bobbyfordmusic-collab/visaverse-site/parts/1_BASE.3mf

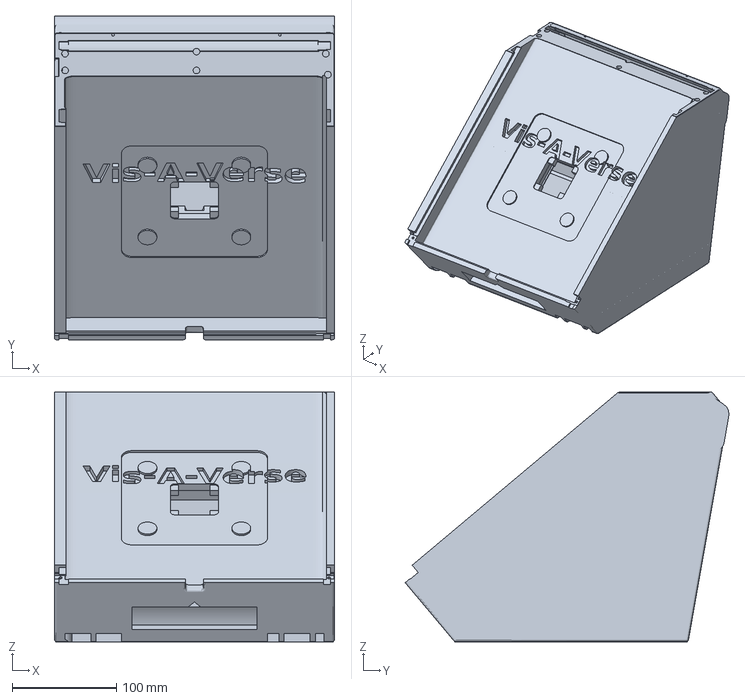
[picture p1: CAD file, 2026-09-03]
parts/1_BASE.3mf
268.4 x 310.3 x 239.3 mm
