bobbyfordmusic-collab/visaverse-site/parts/9_SILL_CAP.3mf

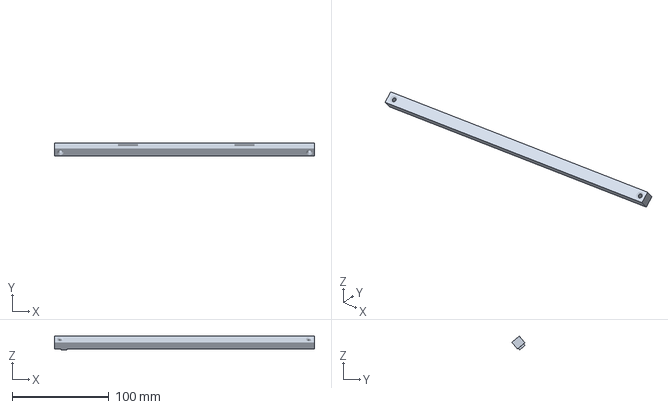
[picture p2: CAD file, 2026-09-03]
parts/9_SILL_CAP.3mf
268.4 x 13.7 x 14.3 mm
