bobbyfordmusic-collab/visaverse-site/parts/4_SHUTTER_LOWER.3mf

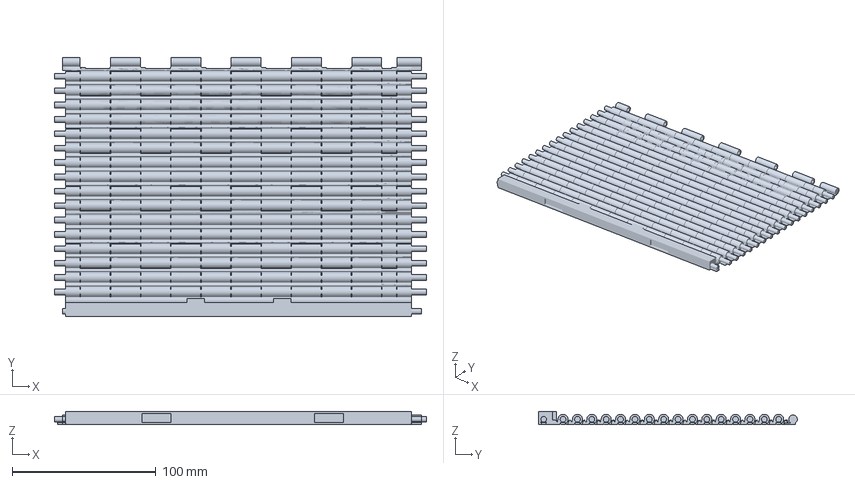
[picture p3: CAD file, 2026-09-02]
parts/4_SHUTTER_LOWER.3mf
258.8 x 180.0 x 8.80 mm
