bobbyfordmusic-collab/visaverse-site/parts/10_DOWEL_PINS.3mf

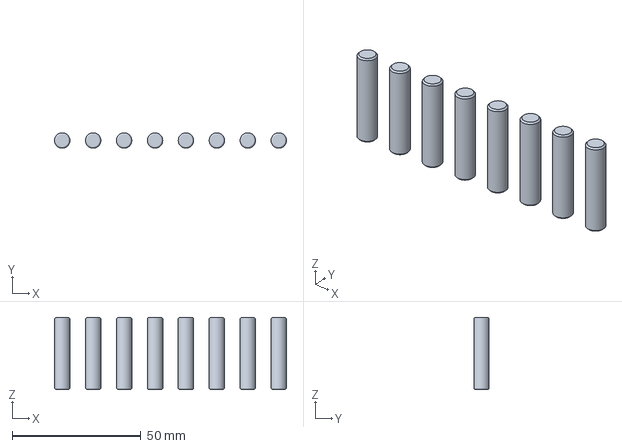
[picture p4: CAD file, 2026-09-02]
parts/10_DOWEL_PINS.3mf
90.0 x 6.00 x 28.0 mm
