bobbyfordmusic-collab/visaverse-site/parts/2_CROWN.3mf

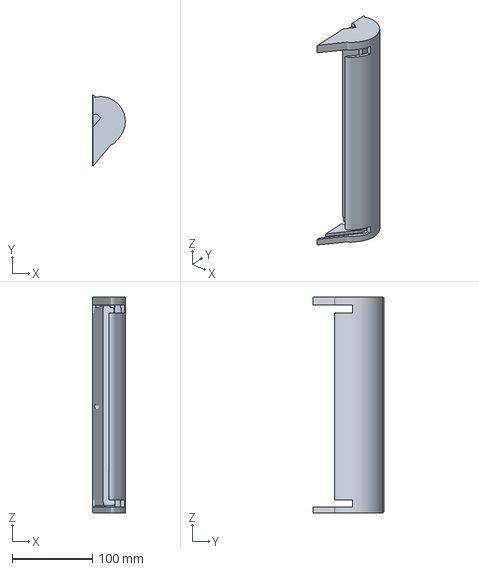
[picture p5: CAD file, 2026-09-02]
parts/2_CROWN.3mf
40.5 x 88.8 x 268.4 mm
