bobbyfordmusic-collab/visaverse-site/parts/8_DOOR_PULL.3mf

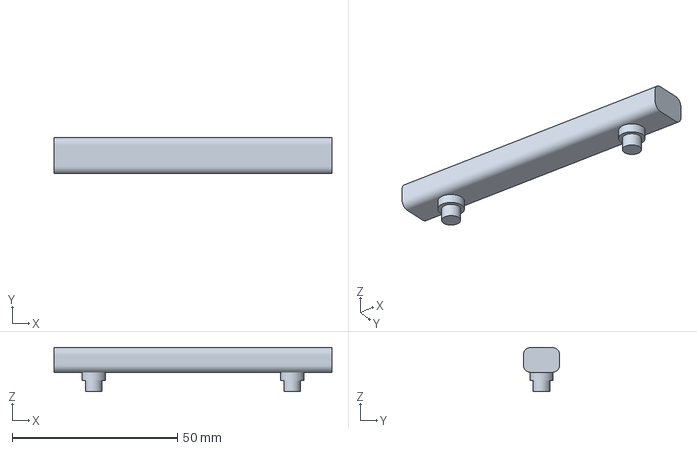
[picture p6: CAD file, 2026-09-02]
parts/8_DOOR_PULL.3mf
84.0 x 11.0 x 13.3 mm
