bobbyfordmusic-collab/visaverse-site/parts/3_LEFT_PANEL_DOOR.3mf

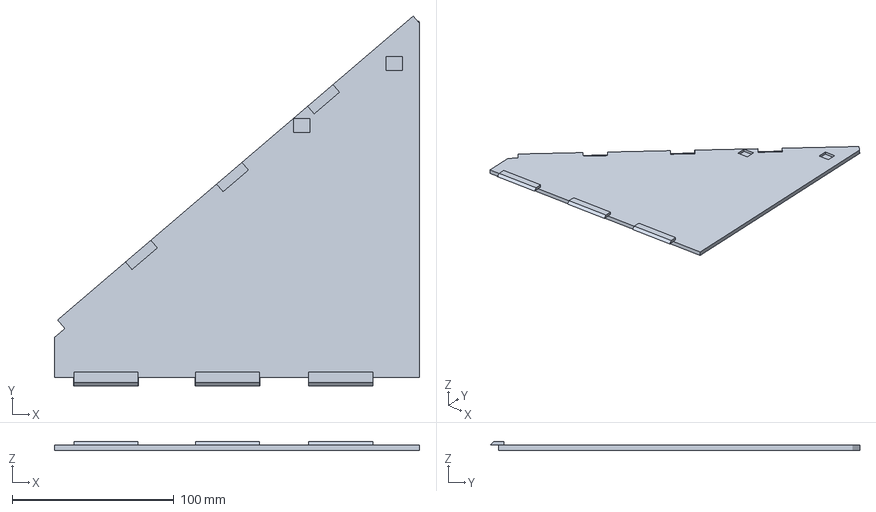
[picture p7: CAD file, 2026-09-02]
parts/3_LEFT_PANEL_DOOR.3mf
225.6 x 228.5 x 5.65 mm
