bobbyfordmusic-collab/visaverse-site/parts/6_TABLET_SLAB.3mf

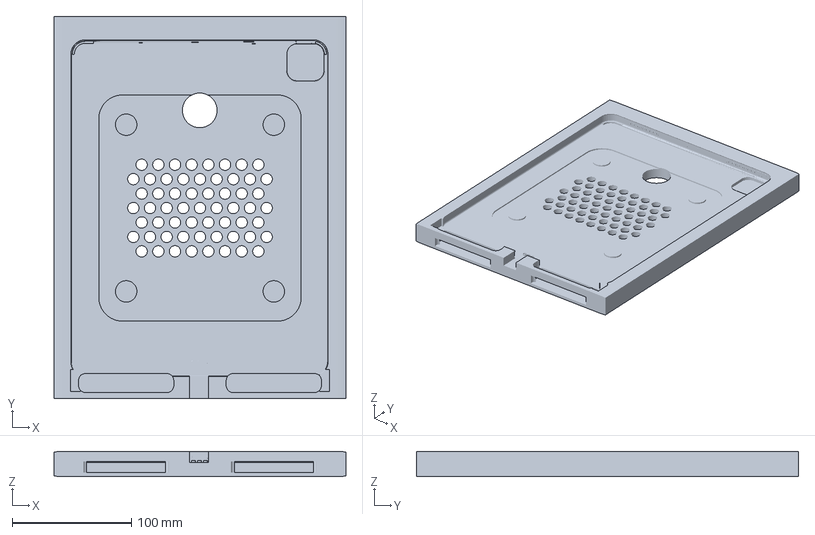
[picture p8: CAD file, 2026-09-01]
parts/6_TABLET_SLAB.3mf
245.2 x 321.0 x 21.0 mm
