bobbyfordmusic-collab/visaverse-site/parts/5_SHUTTER_UPPER.3mf

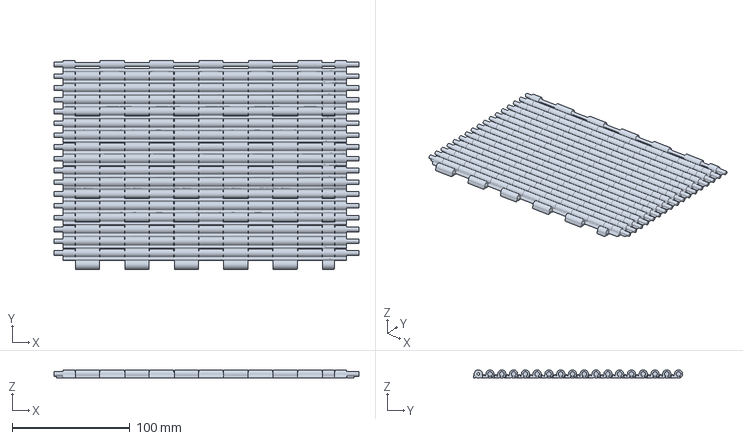
[picture p9: CAD file, 2026-09-01]
parts/5_SHUTTER_UPPER.3mf
258.8 x 177.7 x 7.00 mm
