bobbyfordmusic-collab/visaverse-site/(commit log)

2026-07-29 Add landing page and cross-link site pages
    Claude-Session: https://claude.ai/code/session_017eHAqWx7VCJXQwR2x6YimY
2026-09-01 Add printable part files and the locked-in fit notes
    Stores the 3MF masters for the base, both shutter doors and the sill cap so
    they survive outside a single working session, plus a README recording the
    frozen interfaces (left panel door fit, sill cap, dowel datum, peg length),
    the slope frame the base is measured in, and the checks any base edit has to
    pass.
    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
    [1_BASE.3mf, 4_SHUTTER_LOWER.3mf, 5_SHUTTER_UPPER.3mf, 9_SILL_CAP.3mf]
2026-09-01 Record the left panel door tab sockets measured off the base
    The confirmed door fit is carried entirely by the base, so the three socket
    openings are measured and written down. That makes the fit recoverable from
    the base alone if the door file is ever lost again.
    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
2026-09-01 Widen the base stowing slot so the shutter door can park
    The slot at the top of the base, where the door stows when open, measured
    253.50 mm clear against a 258.80 mm door. Its side walls are moved out to
    -131.62 / +128.40 to match the shutter channel, giving 260.02 clear and the
    same outer wall thickness as the channel. The dowel bores are outside the cut.
    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
    [1_BASE.3mf]
2026-09-01 Fix the crown: widen its door channel and relieve it around the slab
    The crown's channel measured 254.25 mm clear against a 258.80 mm door, with no
    groove on the right side at all. Its walls are moved to -131.62 / +128.40 to
    match the base. Separately the crown overlapped the seated slab by 17.87 cm3
    across the full slab width; the seated slab plus 0.40 mm clearance is relieved
    out of it. Adds the crown and the slab to the stored parts.
    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
    [2_CROWN.3mf, 6_TABLET_SLAB.3mf]
2026-09-01 Relieve the crown over the slab's whole install path, not just its seat
    The crown is glued on permanently and the slab is fitted and removed with it in
    place, so clearing only the seated pose was not enough: tilting the slab's
    bottom out while still seated fouled the crown by up to 0.28 cm3. The swept slab
    over the full tilt-and-slide motion, grown 0.40 mm, is now subtracted. Every step
    of the path reads 0.0000 cm3.
    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
    [2_CROWN.3mf]
2026-09-01 Carry the crown's door channel through to the stowing hand-off
    The channel widening stopped at v=252, leaving the groove narrowed right where
    the door hands off to the base's stowing slot. It now runs to the crown's end,
    so assembled the channel is one uninterrupted 260.02 from v 150 in the base
    through the joint to v 252, past where the stowing slot begins at v 245.
    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
    [2_CROWN.3mf]
2026-09-02 Add dowel pins, and repair two bores the stowing-slot cut had opened
    Sizing the pins showed the stowing-slot widening had reached the dowel bores at
    (-126,124) and (124,124), turning them from 6.30 dia blind holes into open-sided
    slots 8.75 and 7.50 wide. The slot cut is now clamped to y >= 128, which clears
    those bores while still covering the slot's full-width band from y ~130. All six
    bores measure round again.
    Adds 10_DOWEL_PINS.3mf: 6.00 x 28.0 pins with chamfered ends, verified to fit
    both parts at all five shared positions.
    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
    [10_DOWEL_PINS.3mf, 1_BASE.3mf]
2026-09-02 Build the fan mount and a USB park into the base; retire the cartridge
    The fan now mounts directly in the base. The 51 x 51 x 10 pocket and the ledge
    at w 107.42 already existed, but the fan's bolt holes sit inside the 46 mm
    throat where there was no material at all, so four 10 x 10 pads are added in the
    throat corners with 3.4 mm pilots for M4 self-tappers. Fan drops in from the
    cavity, bottoms on the ledge, four screws, blows out toward the slab.
    Also adds a USB-A parking socket in the cavity ceiling beside the fan, and
    stores the left panel door and door pull.
    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
    [1_BASE.3mf, 3_LEFT_PANEL_DOOR.3mf, 8_DOOR_PULL.3mf]
2026-09-02 Move the USB park to the cavity floor, back right
    The ceiling position put the lead across the cavity. The floor there is only
    7.95 mm thick and the thicker rib behind it is 4.15 mm wide, so neither takes a
    13 mm sunk socket; the socket is sunk 5 mm into the floor with an 8 mm collar
    above instead. A USB-A shell inserts at 0.00000 cm3.
    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
    [1_BASE.3mf]
2026-09-02 Trim the sill cap clear of the slab; place and verify the door pull
    The cap's right-hand pad reached 7.4 mm inboard of the slab's edge and dug
    2.29 mm into its front-right corner. The pad is cut back to u 123.00 seated,
    0.375 mm outboard of the slab; cap ^ slab drops from 0.135 to 0.041 cm3, which
    is the 0.04 mm face film across the width.
    Also derives the door pull's placement: two 6.75 pegs into sockets in the lower
    door's z=0 face, verified at 0.00000 cm3, and 0.0000 through the door's travel.
    Records that the sill cap's position along the slope is unresolved - the door
    overlaps it by 12 cm3 where I had it, and clears completely about 8 mm further
    forward, sitting on the sill bar.
    Co-A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
    [9_SILL_CAP.3mf]
2026-09-02 Confirm sill cap placement: the door's bottom edge is the closed stop
    The lower shutter door does not pass over the sill cap - its bottom edge
    bumps into the cap's v -62.949 face, and that contact is what closes the
    shutter and mates the two magnet pairs. Contact falls at cv = -55.949.
    Verified at that stop: 0.0029 cm3 against the cap (the contact plane), and
    0.0000 against the base, the crown and the door pull. Travel from there to
    fully stowed is 0.0000 throughout.
    The previously recorded 12.19 cm3 door/cap clash, and the candidate cap
    position 8 mm further forward, were both artefacts of sweeping the door past
    its physical stop. dv = 93.063 stands.
    Also records the 0.80 mm uniform d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
2026-09-02 Widen the door track over its full length in the base and the crown
    Pre-print audit found the shutter track still at its original 253.50 mm over
    two stretches, against 258.80 mm guide pegs. The pegs are discrete - 3 mm
    long every 10 mm, 16 pairs on the lower panel and 17 on the upper - and run
    the whole length of both panels, so they must follow the track everywhere.
    base, stow slot, z 36..176 (12.603 cm3)
    The slot runs z 36 to 236 and only its top 58 mm had been widened. The
    door would have entered and jammed 58 mm down. Cut as a 10.02 deg tilted
    prism following the slot.
    crown, return leg, z 239..275 (2.253 cm3)
    The leg that hands the door back down into the stow slot. The sl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
    [1_BASE.3mf, 2_CROWN.3mf]
2026-09-02 Fix crown apex track, base seam skin and cap sliver; add panel hinge rod
    Six-way independent audit of the full part set. Confirmed and fixed:
    crown apex (restore +0.293 cm3, re-cut -0.444 cm3)
    The track through the crown is a circular arc (R 26.715 about base
    y 110.428 / z 249.078, rms 0.027, turning 130.0 deg) but the peg groove had
    been cut on a straight tangent. It drifted outward and missed the pegs over
    theta 60..102 - worst 4.10 mm at theta 84 - and at theta 85..95 exited
    through the crown's visible roof, severing it. The roof is restored from the
    original crown and the groove re-cut along the true arc. Pegs now clear at
    every angle 30..150; roof solid 28.00..31.75.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
    [10_DOWEL_PINS.3mf, 1_BASE.3mf, 2_CROWN.3mf, 9_SILL_CAP.3mf]
2026-09-02 Align the base's left sill pilot with the cap; drop the added hinge rod
    The sill cap seats at u = 0, proved three ways: its x extents equal the base's
    exactly (-136.100..132.300), its magnet recesses then line up with the shutter's
    pockets to 0.00 mm, and its right M3 hole lands dead on the base pilot at
    u +127.000. Its left hole is at u -130.000 while the base pilot sat at
    -130.800. The base's left pilot is filled and re-drilled at -130.000; both
    pilots now match the cap's holes.
    The panel-to-panel joint takes a cut length of 1.75 mm filament through the
    overlapping knuckles - the intended assembly method, not a missing part - so
    the Ø2.10 x 250 rod added earlier is removed from 10_DOWE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
    [10_DOWEL_PINS.3mf, 1_BASE.3mf]
2026-09-02 Remove the 0.22 mm floating membrane in the panel-door opening
    A 0.22 mm skin sat at x -132.19..-131.97 over y 107..117, z 31..43 - inside
    the left panel door's opening, 0.01 mm behind the door's inner face, attached
    to nothing. Below one extrusion width, so it prints as a ragged ghost wall or
    stringing right where the door seats. Pre-existing (identical in every
    snapshot back to the base as supplied), not introduced by the track work.
    Removed 0.0345 cm3. The surrounding wall is untouched and still measures
    0.62-1.12 mm where it is real; an earlier, broader cut that also thinned solid
    wall at y 90..106 was reverted before this one.
    C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
    [1_BASE.3mf]
2026-09-02 Close the cavity-floor wedge; record the audit follow-up
    A hairline void ran the full 244 mm width of the cavity floor at
    z 40.97..43.66, opening from 0.075 mm at y 101 to 0.815 mm at y 105 and
    splitting the 8.03 mm floor into two ~4 mm slabs. Closed with a single union
    (+0.5054 cm3), stopping short of y 105.4 so the floor's real opening beyond it
    is untouched.
    Base re-verified after this pass: 43 bodies, watertight, winding-consistent,
    outer bounds unchanged; all six dowel bores round at 6.40 through z 228/232/236;
    track 260.02 mm at z 60/120/180/230; crown seats at 0.00000 cm3.
    The README now records which bore complaints were deliberately left alone and
    why - repairing (0,126)'s rear w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
    [1_BASE.3mf]
2026-09-02 Verify shutter retention along the whole track; record why three bores stand
    The track is a plain slot (x -131.60..+128.38 across the full w band), and the
    shutter is retained by a lip over the slot roof at each edge. Measured base and
    crown together, the lip is continuous from v -60 to v 240 with no gap:
    rod-end span 258.780 slot 259.98 lateral play 1.20 mm
    engagement left 6.18 mm (4.98 in the crown), right 3.20 mm
    For the rod to clear the lip the door must move 3.20 mm sideways and the slot
    allows 1.20 mm. The shutter cannot slip out.
    The right side is deliberately not deepened: taking it to 4.40 mm needs the lip
    at +123.4, and the slab's edge is at +122.625 - any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
2026-09-02 Size the door-pull sockets to the pull's locating boss
    The pull's shank is a Ø4.980 x 3.4 peg followed by a Ø6.95 x 2.4 boss. The
    door's sockets were Ø6.880 - 0.07 mm too small for the boss - so the boss could
    not enter and the pull hung on the peg with 1.90 mm of diametral slop. That
    0.07 mm near-miss says the boss was always meant to be the locating feature.
    Sockets opened to Ø7.290 and re-centred on the pull's own axes (door x -32.775
    and +27.225, y 0.825; the old sockets were 0.075 mm off). The boss now enters
    with 0.17 mm per side and locates the pull over 2.4 mm of engagement, with the
    1.63 mm floor behind the socket kept intact.
    The pull's FACE is unchanged - door z = 0 is th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
    [4_SHUTTER_LOWER.3mf]
2026-09-03 Record the crown's print orientation and drop the flange-chamfer idea
    Measured support-needing area for the crown in every sensible orientation:
    standing as modelled 5,018 mm2, versus 14,756 lying on its side and 24,928
    lying flat. Standing wins by 3-5x because every lying orientation puts
    supports inside the door track, where they cannot be removed.
    The 45-degree flange chamfer I had offered does not survive measurement. The
    crown is a dumbbell - large at both ends, thin through the middle - so standing
    always leaves one large end in the air, and flipping end-for-end does not help.
    At print z 258.3 the section jumps 640 -> 1428 mm2 and the new 1,045.6 mm2
    reaches up to 32.09 mm from supp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
2026-09-03 Trim the sill cap's left pad clear of the slab at u = 0; retire du = -0.453
    Placing the cap at its correct u = 0 (proved by its x extents, the magnet
    alignment and both M3 pilots) moved the left pad's inner edge to u -122.25,
    0.375 mm inboard of the slab's edge at -122.625, so it dug into the slab's
    corner over the pad's 2.29 mm depth - the mirror of the right-pad clash fixed
    earlier. Pad trimmed back to u -123.05 (0.425 clear), 0.0129 cm3 removed,
    bounds unchanged. cap ^ slab is again the 0.040 mm face film
    (w 139.450..139.490); cap ^ base 0.00010; cap ^ lower door at the closed stop
    0.00298 (contact plane), 0 beyond it; cap ^ pull 0.
    Fresh-eyes verification on the full set: all nine par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
    [9_SILL_CAP.3mf]
2026-09-03 Cut the stow-slot strips through to the slot floor
    The deep-slot widening was a straight tilted prism; the slot itself bends
    toward lower y over its last 5 mm (y 104..120 at z 35..42), so the prism
    missed the bottom and the right strip still read 124.00 at z 36..40. The rod
    ends would have stopped on a 2.6 mm step 5 mm above the floor - a wedging stop
    rather than a flat one.
    Both strips now run to the floor over the slot's real band (y 103..121,
    z 34.5..44), 0.5826 cm3 removed. With the panel door fitted the slot reads
    260.60 at z 36..42 and 260.02 at z 44; z 34 is below the floor. Panel door and
    crown still seat at 0.00000. 43 bodies, watertight, bounds unchanged.
    Found by a fresh end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
    [1_BASE.3mf]
2026-09-04 Correct the shutter installation route: front entry, retained by the sill cap
    An earlier note claimed the shutter had to be fed in from the rear before the
    crown was bonded and was unserviceable afterwards. That was wrong. It came
    from a rigid-body sweep that slid a whole 180 mm panel forward at a fixed depth
    - which grinds into the sill lip - and never modelled laying the panel into the
    mouth.
    Measured at the sill mouth, free depth in w is 140.0..158.0 at v -75 and
    136.0..158.0 either side of it. The lip tops at w 139.939, only 1.26 mm proud
    of the door's underside at 138.675, with 18 mm of clear depth above it against
    an 8.80 mm panel. The lip also breaks at u = 0 for the cable notch.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
